silgialloreto/ring-resonator-6GHz/cst/supporti/sostegno_1/Temp/clipboard.bmp

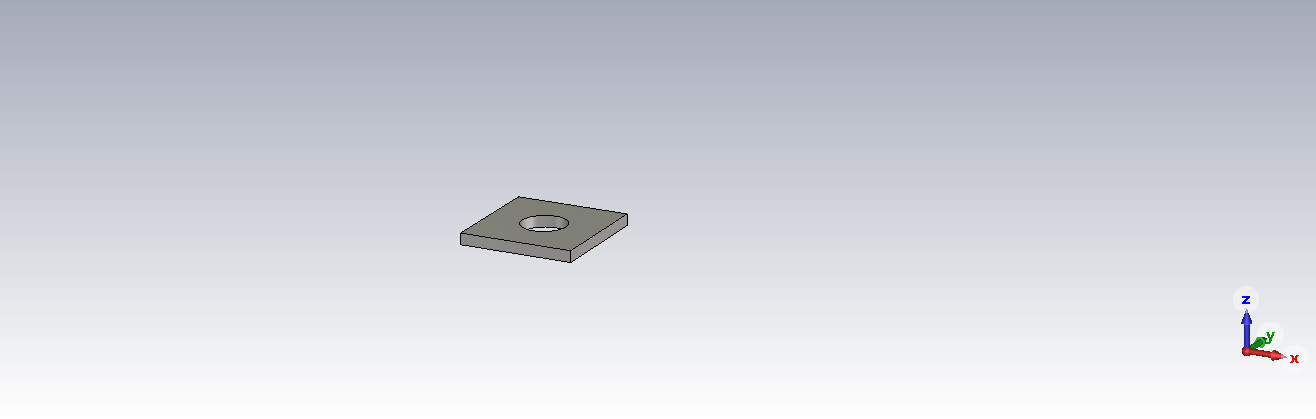
cst/supporti/sostegno_1/Temp/clipboard.bmp
