silgialloreto/ring-resonator-6GHz/cst/supporti/vite/Temp/clipboard.bmp

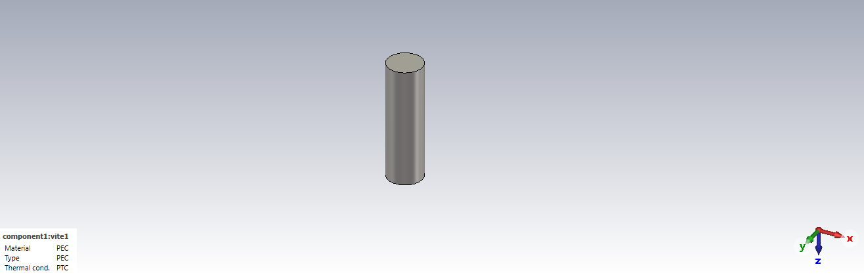
cst/supporti/vite/Temp/clipboard.bmp
