silgialloreto/ring-resonator-6GHz/cst/Ring_Resonator/Temp/clipboard.bmp

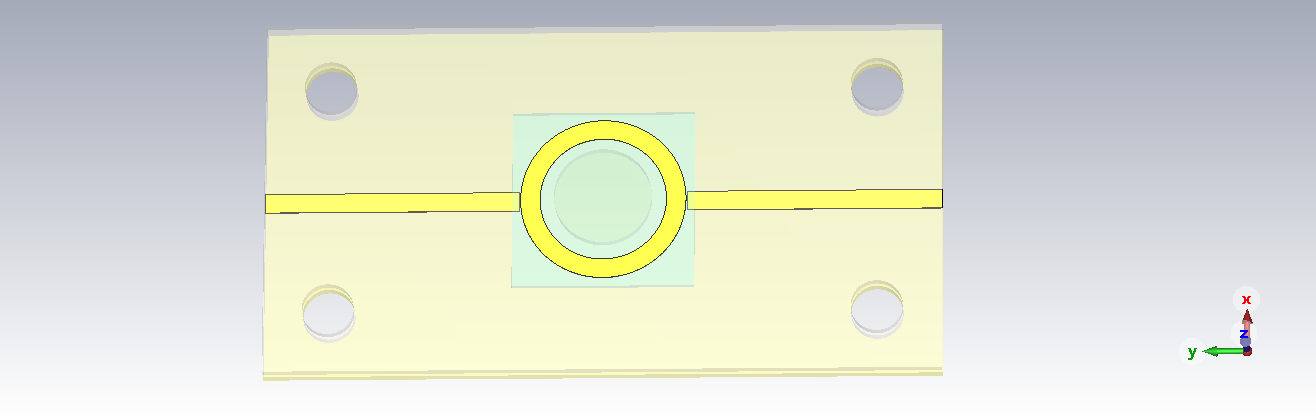
cst/Ring_Resonator/Temp/clipboard.bmp
