silgialloreto/ring-resonator-6GHz/cst/supporti/sostegno_2/Temp/clipboard.bmp

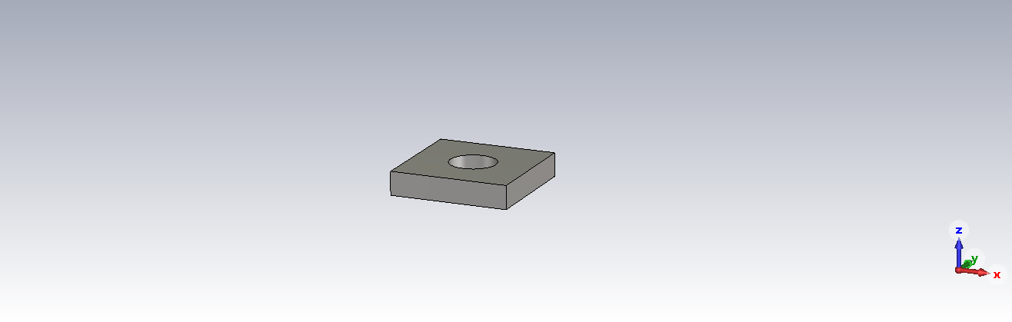
cst/supporti/sostegno_2/Temp/clipboard.bmp
