silgialloreto/ring-resonator-6GHz/(list of files, cad)

Other CAD files:
cst/Ring_Resonator/ModelCache/Model.psm
