silgialloreto/ring-resonator-6GHz/(list of files, drawings)

Other design files:
cst/Ring_Resonator/Model/3D/Model.dsn
cst/Ring_Resonator/Model/DS/Model.dsn
cst/supporti/sostegno_0.5/Model/3D/Model.dsn
cst/supporti/sostegno_0.5/Model/DS/Model.dsn
cst/supporti/sostegno_1/Model/3D/Model.dsn
cst/supporti/sostegno_1/Model/DS/Model.dsn
cst/supporti/sostegno_2/Model/3D/Model.dsn
cst/supporti/sostegno_2/Model/DS/Model.dsn
cst/supporti/vite/Model/3D/Model.dsn
cst/supporti/vite/Model/DS/Model.dsn
