silgialloreto/ring-resonator-6GHz/(commit log)

2026-10-11 first commit
    first commit
    [Model.dsn, Model.psm]
2026-10-11 refactor commit
    change folder organization
    [Model.dsn, Model.psm]
